blankworker1/PVA/README - 2026-10-20T141416.649.md

# PVA — Photovoltaic Art

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

Each panel is three things at once, in order of importance:

1. **A sundial.** A recycled panel on a wall that tells solar time with its gnomon. No visible digital layer: anyone can read it, every day, with no phone.
2. **A self-powered monitor.** Behind the panel, a small board records the panel's own sun every day. The record is collected on foot every fortnight and published on the PVA website as **Sole**: weekly editions of 63 dials, nine panels by seven days.
3. **An annual event.** Once a year, for about a week, **SUNDIAL** turns each panel's day of sun into an image drawn live on the visitor's phone through the panel's own Wi-Fi, sealed at sunset. Visitors can leave a line in each panel's book. The week becomes one four-colour screen print.

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

The three layers are specified against the carrier board in **[USES.md](USES.md)**. PVA runs all three.

> Status: drafts, not yet compiled or tested on hardware. Firmware draft 6 records everything the dial needs (sun sections, heat, presence); the panel page and `tools/pva_rules.py` both draw rules v1. Firmware 6.2 (security, visitors' book, pages built into the firmware, event archive by year) and the Sole tools are specified in USES.md, not yet written.

## How it fits together

| Layer | What it is | When | Where |
| --- | --- | --- | --- |
| **Sundial** | Gnomon, hour brackets and wall plate on the panel ([hardware/SUNDIAL.md](hardware/SUNDIAL.md)) | Always | On the wall |
| **Sole** | The panels' daily record of sun, collected every fortnight, published as weekly editions of 63 dials | All year | The PVA website |
| **SUNDIAL** | Each day's dial drawn live and sealed at sunset; the visitors' book; one print per event | One week a year | The panel's own Wi-Fi, then the website |

| Part | What it is | Where it runs |
| --- | --- | --- |
| The panel | PV panel + ESP32 + temperature probe + clock module, no battery, no internet | On a wall in Bosa |
| The dial | Each day's image, drawn on the visitor's phone from the panel's data | The panel's own Wi-Fi during SUNDIAL; the website for Sole |
| The visitors' book | One line per visitor per panel per day, read and chosen the next day | The panel's own Wi-Fi, during SUNDIAL |
| The map | Route, pins, which panels are likely awake, the visitor's position | The PVA website (this repo's `docs/`) |
| The website pages | SUNDIAL sheets (one per event) and Sole editions (one per week) | The PVA website (planned: `docs/sundial/`, `docs/sole/`) |
| The girasole | A sunflower and a chalkboard: the Heliotropist legend re-enacted, drawn by visitors | First stop of the route during SUNDIAL, moveable |
| The print | The whole event as one 9 × 9 four-colour screen print | Made after each event from the collected data |

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

## Repository

```
USES.md                       the three layers specified against carrier v1: sundial, Sole, SUNDIAL
docs/
  index.html                  the map — the only part published on the website
  sundial/, sole/, data/      planned: SUNDIAL sheets and Sole editions (USES.md 3.3)
firmware/panel_page_server/
  panel_page_server.ino       ESP32 firmware
  partitions.csv              4 MB flash layout for the ELEGOO ESP32 (~2 MB for pages and data)
  partitions_16mb.csv         16 MB layout for an ESP32-S3 (~9.9 MB)
  panel_config.example.h      template for per-panel settings
  data/                       copied into each panel's flash
    index.html                the panel page: today's dial, gallery of past days, live data
    admin.html                admin page: status, clock, exhibition dates, sun-sensor calibration, raw data download
    media/title.txt           this panel's name
    media/map.txt             the map's web address
texts/
  introduction.en.md          the exhibition introduction and the Heliotropism back story (draft)
  introduction.it.md          the same in Italian
  print-enquiry.md            for the print shop: the project, the print, the proposal, eleven questions
  print-enquiry.it.md         the same in Italian
  pva_sample_a4.pdf           A4 sample sheet of the dial (invented data), made by tools/sample_a4.py
  pva_sample_a4.it.pdf        the same in Italian
  pva_poster_mockup.pdf       A4 mock-up of the full print, 63 tiles (invented data), made by tools/poster_mockup.py
  pva_poster_mockup.it.pdf    the same in Italian
  pva_poster_pv_mockup.pdf    the wall version: 63 dials cut as solar cells on black (and .it.pdf)
  slow-art-sun-record.md      Slow Art: Sun Record, a year of Campbell–Stokes sunshine cards in 14 frames, plus sun-drawing workshops
hardware/
  CARRIER.md                  the carrier board: everything factory-fitted except the ESP32 and buck converter
  PVA_carrier_board_spec_v1.pdf  the same as a PDF, for sending to a board designer
  SUNDIAL.md                  the panel as a sundial: gnomon, drilling template, installation, wall test
tools/
  pva_rules.py                the dial rules as drawing code (canonical print, separations); rules-2 for Sole planned
  pva_import.py, sole_edition.py  planned: round downloads → SUNDIAL pages and Sole editions (USES.md 3.4)
  sample_a4.py                A4 sample sheet, invented data
  poster_mockup.py            A4 mock-up of the canonical print, invented data
  requirements.txt
```

## Publishing the map

In the repository's GitHub Pages settings, publish from the `docs` folder on the main branch, then point the PVA domain at it. Only `docs/` is published; the panel files stay in the repo but never appear online.

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

## Preparing a panel

1. **Settings.** Copy `panel_config.example.h` to `panel_config.h` and set the panel's Wi-Fi name (`panel-01` … `panel-09`) and a long, unique admin key. `panel_config.h` is ignored by git; keep the keys somewhere safe.
2. **Build stage.** Set the four switches at the top of the firmware (see the table below). Pins are preset for the ELEGOO 30-pin board; on an ESP32-S3, set them by hand.
3. **Media.** Edit `data/media/title.txt` (panel name) and `data/media/map.txt` (map address).
4. **Build.** Arduino IDE, ESP32 core 3.x; libraries OneWire, DallasTemperature, RTClib. ELEGOO: board *ESP32 Dev Module*, Flash 4 MB, Partition Scheme *Custom* (uses `partitions.csv` in the sketch folder). ESP32-S3: board *ESP32S3 Dev Module*, Flash 16 MB, PSRAM OPI, and rename `partitions_16mb.csv` to `partitions.csv`.
5. **Flash.** Erase all flash first (essential on any board that ever held keys), upload the firmware, then upload `data/` with the LittleFS uploader. **First installation only:** erasing or uploading `data/` wipes the panel's archive and logs. From firmware 6.2 the pages are built into the firmware, and a later update flashes the firmware alone, after a full download (USES.md 4.4).
6. **Set up on site.** Join the panel's Wi-Fi, open `http://192.168.4.1/admin.html`, enter the key, set the clock from your phone and set the exhibition's first and last day.
7. **Calibrate the sun sensor** (if fitted): on a clear day near solar noon, tap **Calibrate now**, **in the two weeks before each event**. On a vertical panel the noon current changes strongly with the season, so the reference must come from the event's own season. Until then the panel still logs the raw current, and the dial's sun sections are drawn as outline.

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

## Installation: the admin checklist (per panel)

**In the workshop**

1. **Settings.** `panel_config.h` from the example: Wi-Fi name (`panel-01` … `panel-09`) and a long, unique admin key, recorded somewhere safe.
2. **Media.** `title.txt` (panel name) and `map.txt` (map address).
3. **Stage switches** to match the hardware fitted. `BENCH` back to `0` before installing.
4. **Flash.** Arduino IDE, ESP32 Dev Module, Custom partitions: erase all flash, upload the firmware, upload `data/` with the LittleFS uploader.
5. **Power chain.** Buck converter set to exactly 5.0 V before anything is connected; then fuse, diode, supercapacitor, TVS.
6. **Sensors.** Probe on GPIO 4 · divider on GPIO 34 · DS3231 on GPIO 21/22 · sun sensor gate on GPIO 25, amplifier on GPIO 35.
7. **Bench test.** On USB: set the clock, set the exhibition dates to today, check status (clock module fitted, probe found, voltage plausible), watch a dial form.
8. **Frame.** Drill from the template; fit the gnomon at 50°, the 13 numbered hour brackets and the stand-off brackets ([hardware/SUNDIAL.md](hardware/SUNDIAL.md)).

**On site**

9. **Permission** from the wall owner and the Comune (and heritage authorities in the centro storico) **for a permanent installation**, plus public liability insurance (USES.md section 5).
10. **Wall test.** Compass for a first reading, then the noon-shadow test: which edge packs out, and by how much.
11. **Mount.** Cut the stand-offs, hang, spirit level against the glass; box on the deep side, probe on the panel back.
12. **Wall plate** beside the panel: its number and the QR code.
13. **Solar-noon check.** The shadow falls on the 12 bracket; adjust the stand-offs if not.
14. **Admin page.** Join the panel's Wi-Fi, open `http://192.168.4.1/admin.html`, enter the key, set the clock and the exhibition dates.
15. **Calibrate the sun sensor** on a clear day near solar noon, in the two weeks before the event starts. Uncalibrated, every section draws as an outline.
16. **Map pin.** Map with `?edit`, drag the pin, copy the positions into `docs/index.html`, push.

**The girasole (once, for the whole trail)**

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

**During the run**

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

**After the run**

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

**All year (Sole)**

20. **Fortnightly round, every second Monday:** status, clock check, full download, clean the glass, check gnomon, plate and box; one line per panel in the round log. Then import, build the two new weekly editions, push. Details: USES.md 3.2.

**Every year (USES.md 4.4)**

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

## The visitor's experience

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

## To do

- [ ] **Import script:** turn an admin download into tile data for `pva_rules.py`, the canonical sheet and the website page.
- [ ] **Separations script:** one file per ink for the screen print.
- [ ] **Website page** for the canonical sheet, filled after each day's round.
- [ ] **Calibration** of every panel before the run; prove the step on the pilot.
- [ ] **"How to read the dial" key** in the panel page's info overlay, as well as on the flyer and website.
- [ ] **Italian and English** on the panel page, info overlay and map.
- [ ] **"Stay connected"** wording on the flyer or wall plate: some phones warn about or drop a network with no internet.
- [x] **After the last day:** the panel page shows the archive of past events (USES.md 4.1).
- [ ] **Firmware 6.2** (USES.md 4.1): challenge-and-response admin login with round and setup keys, lockout and action log; the visitors' book; pages built into the firmware; no visitor clock-setting when the clock module is fitted; rules version check; event archive by year.
- [ ] **Permissions** for a permanent installation: wall owners, Comune and heritage, insurance (USES.md section 5).
- [ ] **Sole tools and pages:** rules-2 in `pva_rules.py`, `pva_import.py`, `sole_edition.py`, `docs/sole/` and `docs/sundial/` (USES.md 3.3–3.4).
- [ ] **First compile and bench test** of firmware draft 6.
- [ ] **The girasole:** sunflower variety and sowing in May; a moveable chalkboard and its stand; where it stands on the route.
- [ ] **Hour lines on the glass** (test on the pilot panel): thin or dotted lines radiating from the gnomon root at the hour-line angles in `hardware/SUNDIAL.md`, in removable UV-stable pinstripe tape first. Measure short-circuit current near solar noon with and without the lines. If the loss is negligible and the dial reads well, keep the lines and shorten the gnomon (safer, less reach from the wall), since the shadow is then read along the line, not at the brackets.

**Optional**

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

## Hardware per panel

Each panel is also a vertical sundial, mounted vertical and facing due south: see [hardware/SUNDIAL.md](hardware/SUNDIAL.md) for the gnomon, the drilling template, the installation and the noon-shadow wall test.

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

**Stage 2 adds** (or the carrier board in `hardware/CARRIER.md`, which fits all of this): fuse and reverse-polarity diode on the panel side · SMAJ5.0A TVS diode across 5 V · panel-voltage divider 100 kΩ / 5.6 kΩ + 100 nF into GPIO 34 (must be GPIO 32–39: the other analog pins stop working with Wi-Fi on) · DS3231 clock module on GPIO 21/22.

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

## The dial (rules v1, draft)

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

*Horas non numero nisi serenas* — I count only the sunny hours.

## What a panel records

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

## Data and privacy

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
