blankworker1/PVA/texts/pva_poster_pv_mockup.it.pdf

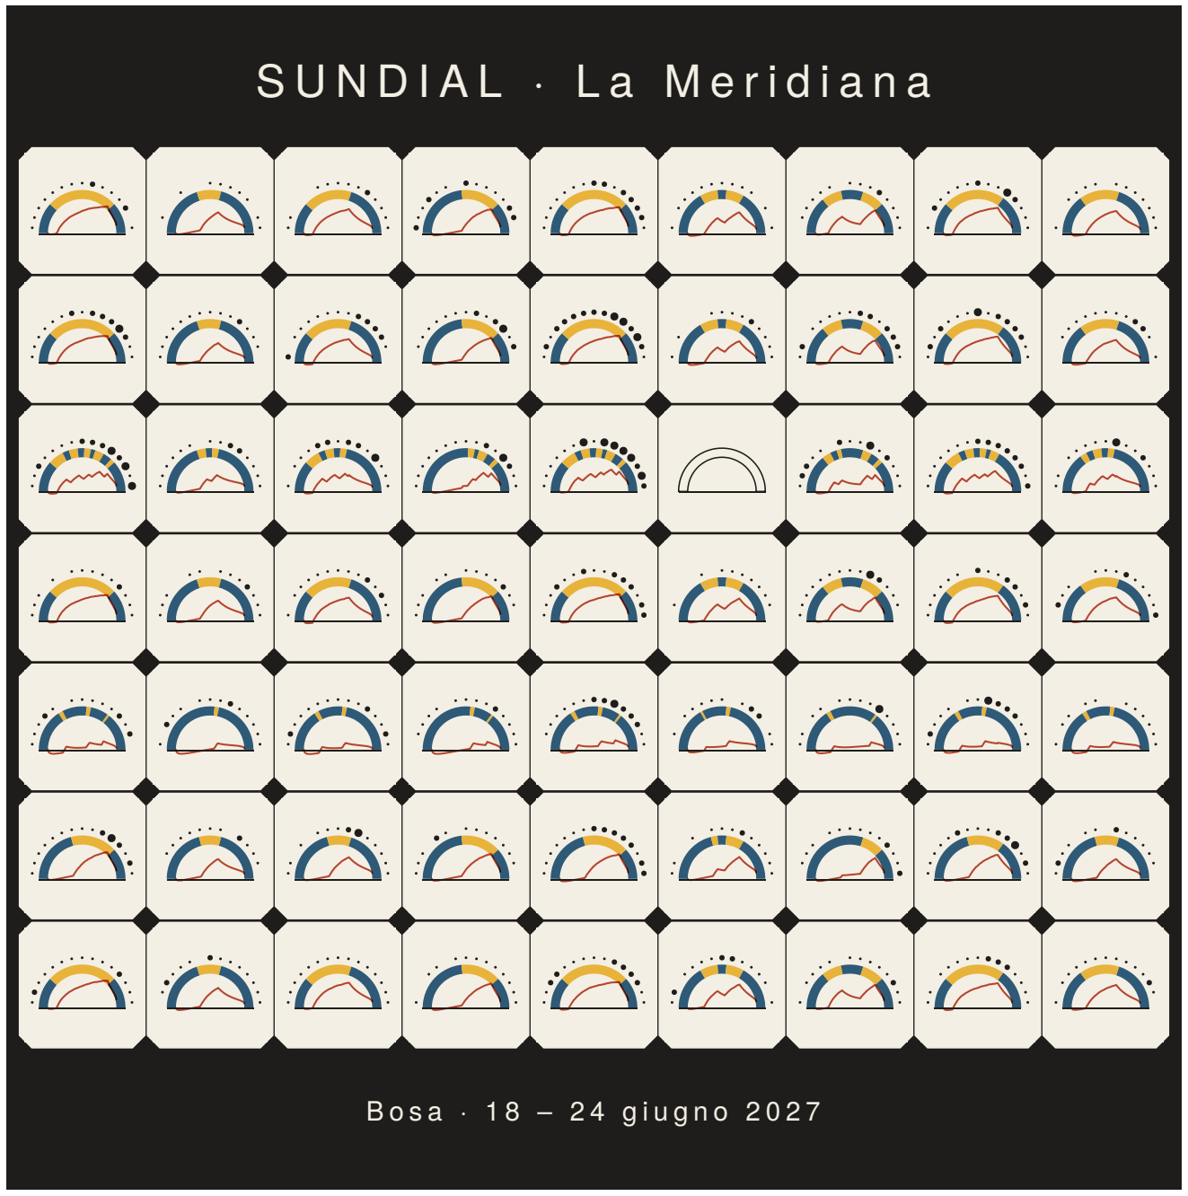
[picture p1: figure]

Bozza della versione a parete · 9 pannelli (colonne) × 7 giorni (righe) · dati inventati · regole v1 (bozza)
Lo stesso cielo per tutti e nove: nuvole il 20, coperto il 22, mattina nuvolosa il 23. Il pannello 6 non si è acceso il 20.
63 fogli A4 tagliati a celle di 210 mm, angoli smussati di 30 mm, su nero: il rovescio di un pannello vero. Fughe 2 mm (luoghi), 4 mm (giorni). Misura 1,95 × 1,96 m.
