blankworker1/PVA/texts/introduction.it.md

<!-- Bozza, ottobre 2026. Copia di lavoro: il doc "SUNDIAL · La Meridiana – Exhibition Introduction", scheda Italiano. Non ancora pubblicato. -->

# SUNDIAL · La Meridiana

**Nove pannelli. Un solo sole. Sette giorni a Bosa.**

Per sette giorni attorno al solstizio d'estate, nove vecchi pannelli solari sono appesi ai muri di Bosa. Hanno finito la loro vita di lavoro sui tetti. Ora gli resta un solo compito: guardare il sole, e fare un'immagine di ciò che hanno visto.

Ogni pannello alimenta soltanto sé stesso. Niente batteria, niente cavi, niente internet. Quando arriva la luce, il pannello si sveglia. Per tutto il giorno registra il sole sul proprio vetro, quanto si scalda e chi si ferma a fargli visita. Da questo, secondo regole fisse, disegna un'unica immagine: il quadrante della sua giornata. L'immagine si forma dal vivo, minuto dopo minuto, e viene sigillata al tramonto di Bosa. Da quel momento nulla può più cambiarla.

La si può vedere solo lì, davanti al pannello, sul proprio telefono, attraverso il Wi-Fi del pannello stesso. Ogni pannello è anche una vera meridiana: la sua ombra segna l'ora solare, mentre i suoi dati disegnano la giornata.

Tutti e nove i pannelli vedono lo stesso sole. Nessuno vede la stessa giornata. Una via che guarda il mare, un muro all'ombra del castello, un vicolo che perde il sole alle tre del pomeriggio: ogni luogo si scrive nel proprio quadrante. **Stesso sole, dati diversi.**

A settimana finita, i 63 quadranti, nove pannelli per sette giorni, diventano un'unica serigrafia, stampata a Bosa in quattro inchiostri: tutta la mostra in un solo foglio.

*Horas non numero nisi serenas.* Conto solo le ore serene.

## Visitare

- **Quando:** sette giorni a giugno 2027, attorno al solstizio (date da confermare). I pannelli si svegliano con la luce e si spengono dopo il tramonto: non ci sono orari di apertura, se non quelli del sole.
- **Dove:** nove muri di Bosa. Inquadra il codice QR sul volantino o sulla targa di un pannello: trovi la mappa, il percorso e quali pannelli sono svegli in quel momento.
- **Si parte dal girasole:** la prima tappa sulla mappa. Un giovane girasole si volge al sole accanto a una lavagna: lascia il tuo segno, ocra per il sole o blu per l'ombra, e scrivi l'ora. Al tramonto la lavagna si cancella, pronta per il giorno dopo.
- **Come:** davanti a un pannello, collegati al suo Wi-Fi (da `panel-01` a `panel-09`). La pagina si apre da sola. Resta collegato anche se il telefono dice che non c'è internet: non c'è, ed è voluto.
- **Costo:** gratuito. La tua visita viene contata, mai identificata: diventa un piccolo punto nero su quell'ora del quadrante.

## Eliotropismo: una breve storia, in gran parte inventata

L'**Eliotropismo** è l'arte di volgersi verso il sole. Il nome viene dalla botanica, dove indica una pianta che segue il sole nel cielo: da *Helios*, il sole, e *tropos*, il volgersi. I suoi seguaci sono gli Eliotropisti. Il suo motto è l'antica iscrizione delle meridiane, *Horas non numero nisi serenas*, e le sue opere le fa il sole e non le firma nessuno.

**La leggenda.** Gli Eliotropisti dicono che il loro primo membro fu un girasole. Nessuno lo aveva piantato. Un uccello lasciò cadere il seme in una crepa, ai piedi di un vecchio muro rivolto al mare, in una città sul fiume, sotto una meridiana così consumata che se ne leggeva solo il motto: *Horas non numero nisi serenas*.

Per tutta l'estate il fiore fece ciò che fanno i girasoli. Seguì il sole da est a ovest, e ogni notte, al buio, si rigirò verso est ad aspettare. Quando passava una nuvola, aspettava. Quando il sole scendeva dietro il castello, aspettava. Dopo il tramonto non contava niente. La meridiana sopra di lui non sapeva più segnare le ore; il fiore, sotto, segnava soltanto quali erano serene.

Qualcuno che passava ogni giorno davanti al muro cominciò a tracciare segni sul muro dietro il girasole: un segno ogni quarto d'ora, un colore per il sole e un altro per l'ombra, ogni giornata chiusa al tramonto e mai più toccata. Alla fine dell'estate il muro era coperto di giornate senza firma, nessuna uguale all'altra, tutte fatte dallo stesso sole. Il girasole andò in seme. I segni rimasero sul muro. Quella, dicono gli Eliotropisti, fu la prima mostra.

**I secoli silenziosi.** Per molto tempo l'Eliotropismo ha avuto pochissimi membri dichiarati, perché un Eliotropista non può dire di esserlo. La sua storia è scritta nei vuoti: meridiane senza firma, ombre lasciate a disegnare da sole, barattoli forati lasciati sulle recinzioni per mezzo anno. Gli Eliotropisti riconoscono le opere gli uni degli altri, mai le persone.

**I pannelli.** L'Eliotropismo aspettava un materiale capace di vedere il sole e anche di dimenticarlo. Lo ha trovato nel pannello solare a fine vita: troppo stanco per alimentare una casa, ancora abbastanza sveglio per accorgersi della luce. SUNDIAL · La Meridiana è, dicono gli Eliotropisti, la prima mostra del movimento dai tempi del girasole, e anche l'ultima, fino alla prossima. I pannelli restano fermi; sono i visitatori a volgersi, camminando da un muro all'altro dietro la luce.

**Eliotropisti senza saperlo.** Il movimento è molto più grande di quanto i suoi membri ammettano. Ogni estate migliaia di persone si volgono a sud e seguono il sole fino a paesi come Bosa: organizzano le giornate in base a lui, spostano l'asciugamano con l'ombra, giudicano una vacanza dalle sue ore di sole. Per gli Eliotropisti, ognuno di loro è un membro. Come i pannelli, tornano ogni anno sotto lo stesso sole, e come i pannelli, nessuno di loro ha la stessa giornata.

**Le regole dell'Eliotropismo**

1. L'opera la fa il sole. L'artista scrive solo le regole, e le regole sono fissate prima della prima luce.
2. Un pannello, un luogo, un giorno. Ogni opera appartiene al luogo in cui è nata.
3. Un'opera è finita al tramonto. Ciò che viene dopo il buio non si conta.
4. L'ombra non è un fallimento. Il blu è una registrazione vera, non una mancanza.
5. Un giorno in cui il pannello non si è svegliato è comunque un'opera: il contorno di ciò che avrebbe potuto essere.
6. L'opera si vede dove nasce, o non si vede affatto.
7. I visitatori si contano, non si nominano.
8. L'opera non la firma nessuno. Al posto della firma, le regole portano un numero di versione.
9. Conta solo le ore serene.
