blankworker1/PVA/texts/pva_sample_a4.it.pdf

# SUNDIAL · La Me ridiana

### PVA Bosa · foglio di prova · regole v1 (bozza) · due giorni, due luoghi

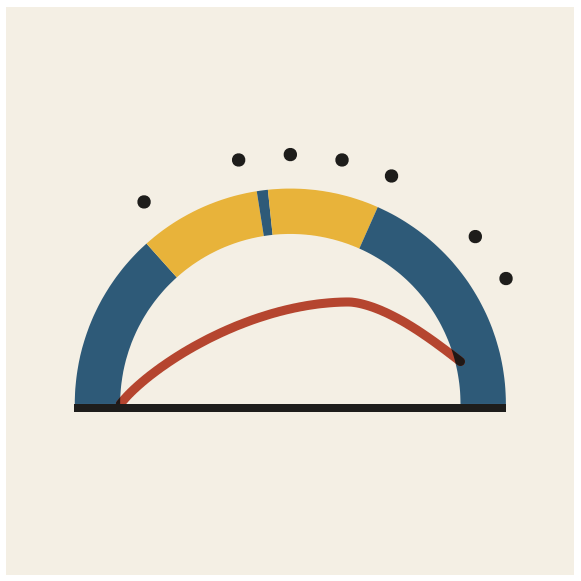
[picture p2: figure]

## Pannello 3 · vicolo stretto

21 giugno 2026 · alba 05:57 · mezzodì solare 13:29 · tramonto 21:00

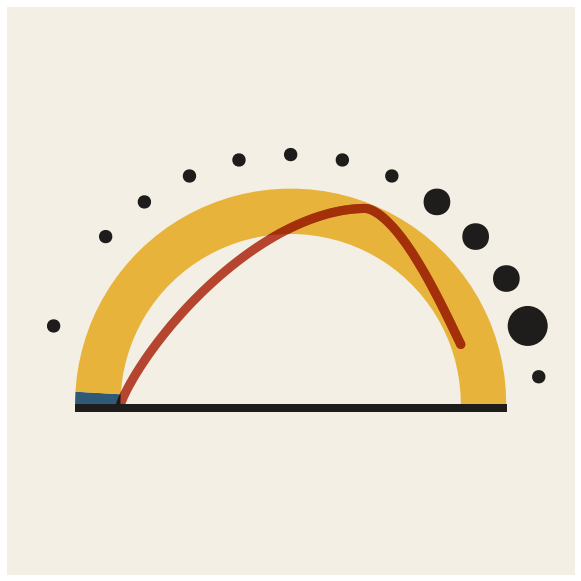
[picture p3: figure]

## Pannello 9 · di fronte al mare

21 giugno 2026 · alba 05:57 · mezzodì solare 13:29 · tramonto 21:00

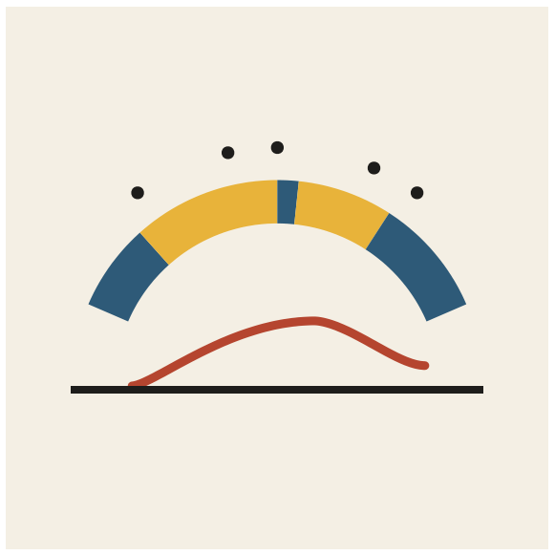
[picture p4: figure]

## Pannello 3 · vicolo stretto

16 ottobre 2026 · alba 07:38 · mezzodì solare 13:12 · tramonto 18:46

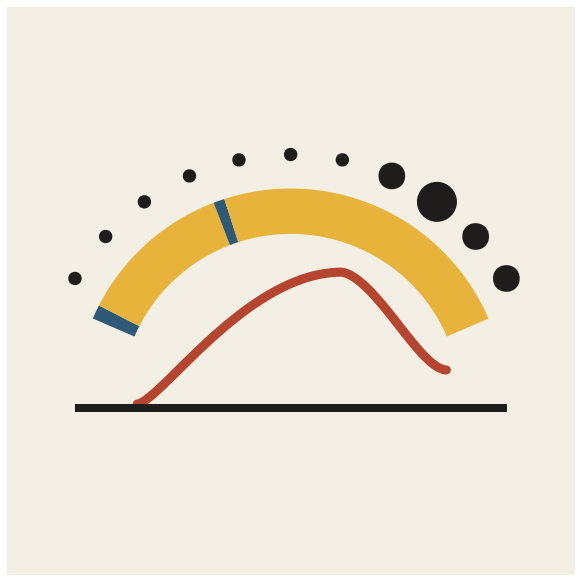
[picture p5: figure]

## Pannello 9 · di fronte al mare

16 ottobre 2026 · alba 07:38 · mezzodì solare 13:12 · tramonto 18:46

Un giorno in cui il pannello non si è acceso: il contorno dell'anello e l'asse, solo in nero. Sono le linee più sottili del foglio.

al sole | non al sole | calore: aumento dall'alba, +40 °C all'anello | visitatori per ora solare: 1–5 · 6–10 · 11+

Dati inventati, a scopo illustrativo. Ampiezza dell'arco = durata del giorno rispetto al solstizio di Bosa (180°). Mezzogiorno solare in alto.
