blankworker1/PVA/texts/pva_sample_a4.pdf

# SUNDIAL · La Me ridiana

### PVA Bosa · sample sheet · rules v1 (draft) · two days, two locations


## Panel 3 · narrow street

21 June 2026 · sunrise 05:57 · solar noon 13:29 · sunset 21:00


## Panel 9 · facing the sea

21 June 2026 · sunrise 05:57 · solar noon 13:29 · sunset 21:00


## Panel 3 · narrow street

16 October 2026 · sunrise 07:38 · solar noon 13:12 · sunset 18:46


## Panel 9 · facing the sea

16 October 2026 · sunrise 07:38 · solar noon 13:12 · sunset 18:46

A day the panel did not wake: the outline of the ring and the axis, in black only. These are the thinnest lines on the sheet.

in sun | not in sun | heat: rise since sunrise, +40 °C at the ring | visitors per solar hour: 1–5 · 6–10 · 11+

Invented data for illustration. Arc angle = day length against Bosa's solstice day (180°). Solar noon at the top.
