blankworker1/PVA/texts/print-enquiry.it.md

<!-- Bozza, ottobre 2026. Copia di lavoro: il doc "SUNDIAL · La Meridiana – Per la stamperia" (scheda Italiano). Per il titolare della stamperia, con pva_sample_a4.it.pdf. -->

# SUNDIAL · La Meridiana – Per la stamperia

## Il progetto

**SUNDIAL · La Meridiana** è la prima mostra di PVA (Photovoltaic Art), a Bosa, per sette giorni attorno al solstizio d'estate 2027. Nove vecchi pannelli solari, appesi ai muri del paese, alimentano soltanto sé stessi: niente batteria, niente cavi, niente internet. Ogni pannello è anche una vera meridiana.

Ogni giorno ogni pannello registra il sole sul proprio vetro, quanto si scalda e chi si ferma a fargli visita, e secondo regole fisse ne disegna un'immagine: il quadrante della sua giornata, sigillato al tramonto. Durante la mostra lo si vede solo sul telefono, davanti al pannello. **Stesso sole, dati diversi.**

A mostra finita, i 63 quadranti (nove pannelli per sette giorni) diventano un'unica serigrafia in quattro inchiostri, stampata a Bosa: tutta la mostra in un solo foglio. È questa la stampa che vorremmo realizzare e vendere con voi.

## La stampa

| Voce | Specifica |
| --- | --- |
| Impaginazione | Quadrata, griglia 9 × 9: 63 riquadri immagine (9 pannelli × 7 giorni); "SUNDIAL · La Meridiana" centrato nella riga in alto, le date centrate nella riga in basso |
| Colori | 4 inchiostri a tinta piatta, stampati dal più chiaro al più scuro: ocra, rosso, blu, nero |
| Sovrastampa | Inchiostri trasparenti: il rosso sopra l'ocra o il blu crea un terzo colore |
| Grafica | Forme vettoriali piatte, senza sfumature né retini |
| Linee più sottili | Da fissare con voi in millimetri, una volta nota l'area di stampa (vedi domanda 1). Alcuni riquadri, i giorni in cui un pannello non si è acceso, sono solo un contorno nero sottile |
| File | Forniamo le quattro selezioni a misura di stampa, con crocini di registro, pronte per la pellicola |
| Formato | Il più grande che il vostro telaio permette, immagine quadrata, carta quadrata |

## La proposta

La stamperia realizza i telai, stampa e vende le stampe, che si possono ordinare in qualsiasi momento dopo la mostra. PVA resta proprietaria dei telai (o delle pellicole, se è più pratico). Ogni stampa deve essere uguale alla prima, in qualunque momento venga fatta.

## Le domande

1. **Area di stampa:** qual è l'immagine più grande che potete stampare con il vostro telaio più grande? Da questa dipendono la misura di ogni riquadro e lo spessore minimo delle linee.
2. **Linee sottili:** qual è la linea più sottile che tenete con sicurezza su carta, in quattro passaggi?
3. **Carta:** quale carta consigliate per quattro colori, e potete tagliarla quadrata (per esempio 70 × 70 cm da un 70 × 100)?
4. **Inchiostri:** stampate su carta con inchiostri all'acqua, e potete aggiungere la base trasparente per la sovrastampa? Potete annotare le miscele, così che le stampe successive siano uguali?
5. **Registro:** potete mettere a registro quattro colori con precisione, con giostra, tavolo o spine?
6. **Prova:** potreste tirare una piccola prova di rosso sopra ocra, e di una linea sottile nera, sulla carta scelta?
7. **Telai o pellicole:** è meglio che PVA tenga quattro telai, oppure le pellicole, rifacendo i telai quando serve? Dove verrebbero conservati?
8. **Tiratura:** aperta (stampata su richiesta) o limitata e numerata? Cosa consigliate?
9. **Costi e vendite:** costi di avviamento (pellicole, telai), prezzo per stampa e come dividere i ricavi.
10. **Tempi:** quanto tempo dalla consegna dei file alle prime stampe?
11. **Vendita:** in negozio, online, o entrambi?

## Il foglio di prova

Quattro quadranti con dati inventati: due luoghi, il giorno del solstizio e un giorno d'ottobre. In basso, un giorno in cui il pannello non si è acceso, solo in nero: sono le linee più sottili della stampa. Vedi `pva_sample_a4.it.pdf`.

**Come si legge un quadrante.** L'anello va dall'alba (a sinistra) al tramonto (a destra), con il mezzogiorno solare in alto; è diviso in quarti d'ora, ocra quando il pannello è al sole, blu quando non lo è. La linea rossa è il calore del pannello, che sale dall'alba. I punti neri sono i visitatori, uno per ogni ora solare. La barra nera in basso è l'orizzonte e il sigillo del tramonto.
