blankworker1/PVA/texts/pva_poster_mockup.pdf

# S U N D I A L · L a M e r i d i a n a

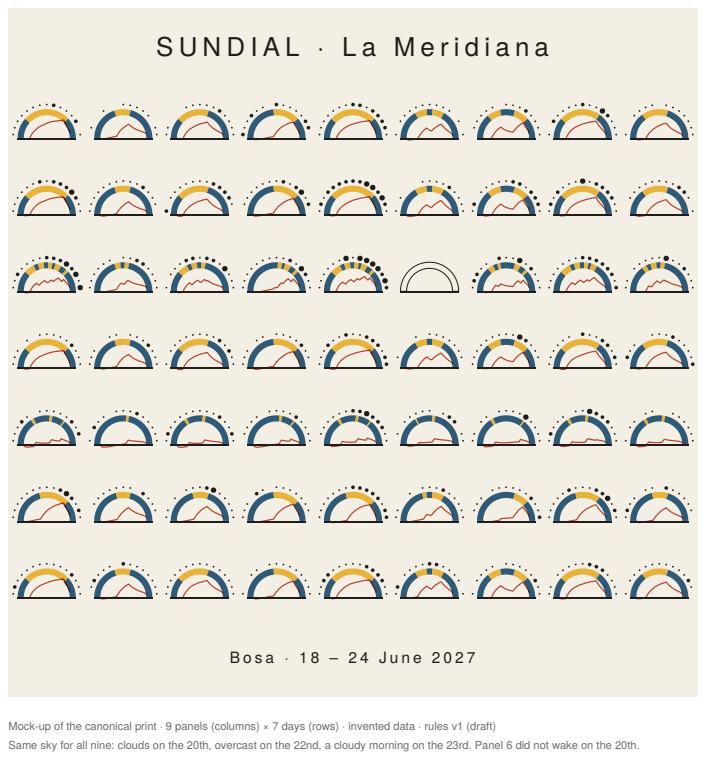
[picture p6: page 1]

Mock-up of the canonical print · 9 panels (columns) × 7 days (rows) · invented data · rules v1 (draft)
Same sky for all nine: clouds on the 20th, overcast on the 22nd, a cloudy morning on the 23rd. Panel 6 did not wake on the 20th.
