blankworker1/PVA/texts/pva_poster_pv_mockup.pdf

# S U N D I A L · L a M e r i d i a n a

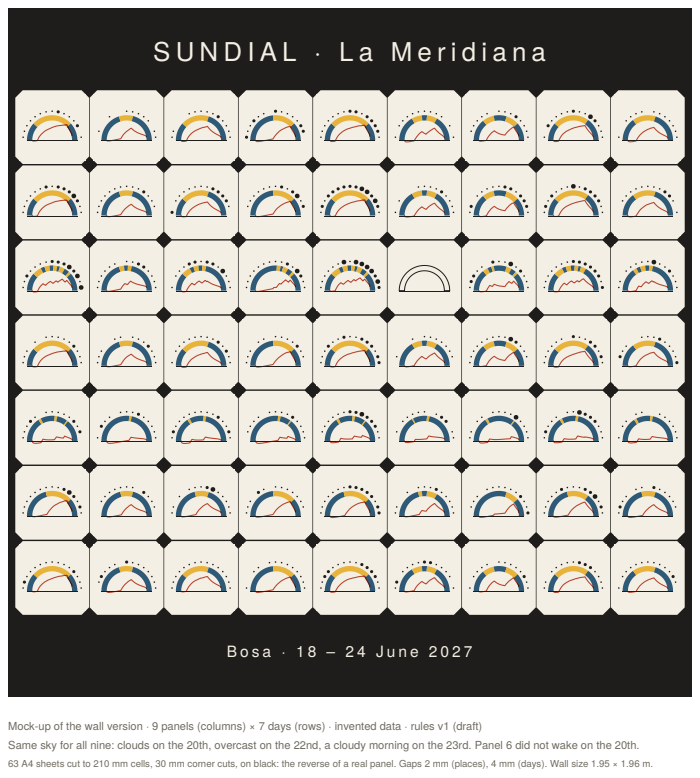
[picture p7: page 1]

Mock-up of the wall version · 9 panels (columns) × 7 days (rows) · invented data · rules v1 (draft)
Same sky for all nine: clouds on the 20th, overcast on the 22nd, a cloudy morning on the 23rd. Panel 6 did not wake on the 20th.
63 A4 sheets cut to 210 mm cells, 30 mm corner cuts, on black: the reverse of a real panel. Gaps 2 mm (places), 4 mm (days). Wall size 1.95 × 1.96 m.
