blankworker1/PVA/hardware/carrier/carrier_schematic.pdf

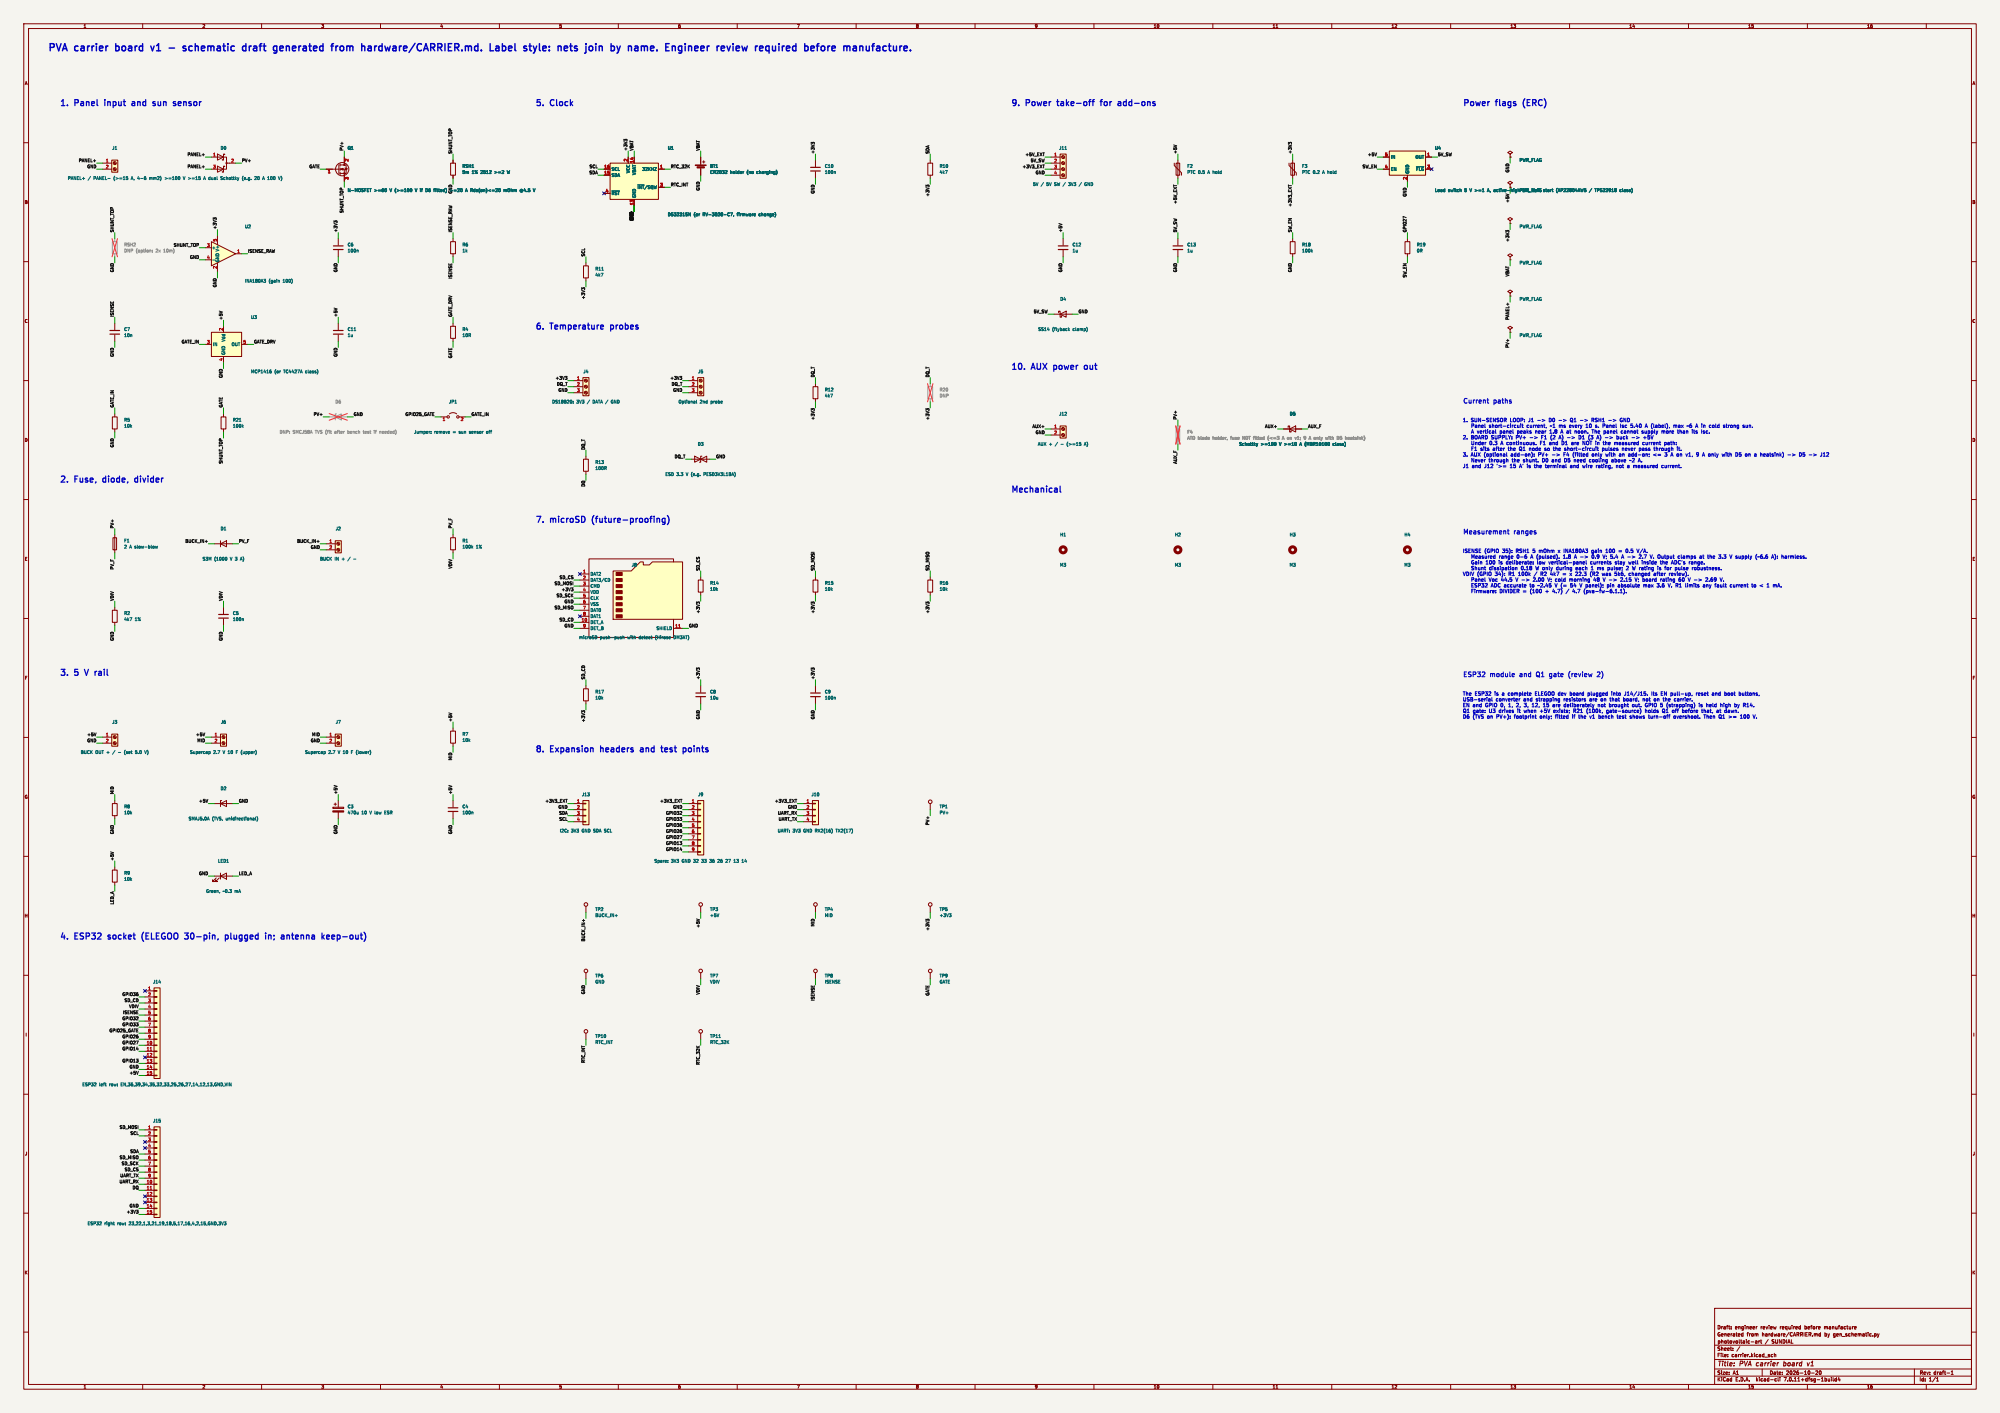
[picture p8: page 1]

1. Panel input and sun sensor

2 3 Q1 N-MOSFET >=60 V (>=100 V if D6 fitted) >=20 A Rds(on)<=20 mOhm @4.5 V

2 ~{INT}/SQW3 ~{RST} 4 Q1 N-MOSFET >=60 V (>=100 V if D6 fitted) >=20 A Rds(on)<=20 mOhm @4.5 V

2 ~{INT}/SQW3 ~{RST} 4 U1 DS3231SN (or RV-3028-C7, firmware change) R6

Load switch 5 V >=1 A, active-high PWR_FLAG EN, soft start (AP22804AW5 / TPS22918 class) D6 DNP: SMCJ58A TVS (fit after bench test if needed)

Jumper: remove = sun sensor off

ESP32 module and Q1 gate (review 2)

8. Expansion headers and test points

J10 UART: 3V3 GND RX2(16) TX2(17) LED1 Green, ~0.3 mA

J14 ESP32 left row: EN,36,39,34,35,32,33,25,26,27,14,12,13,GND,VIN

Id: 1/1 Title: PVA carrier board v1
