blankworker1/PVA/hardware/carrier/carrier.kicad_sch

## KiCad design hardware/carrier/carrier.kicad_sch (2026-10-20)

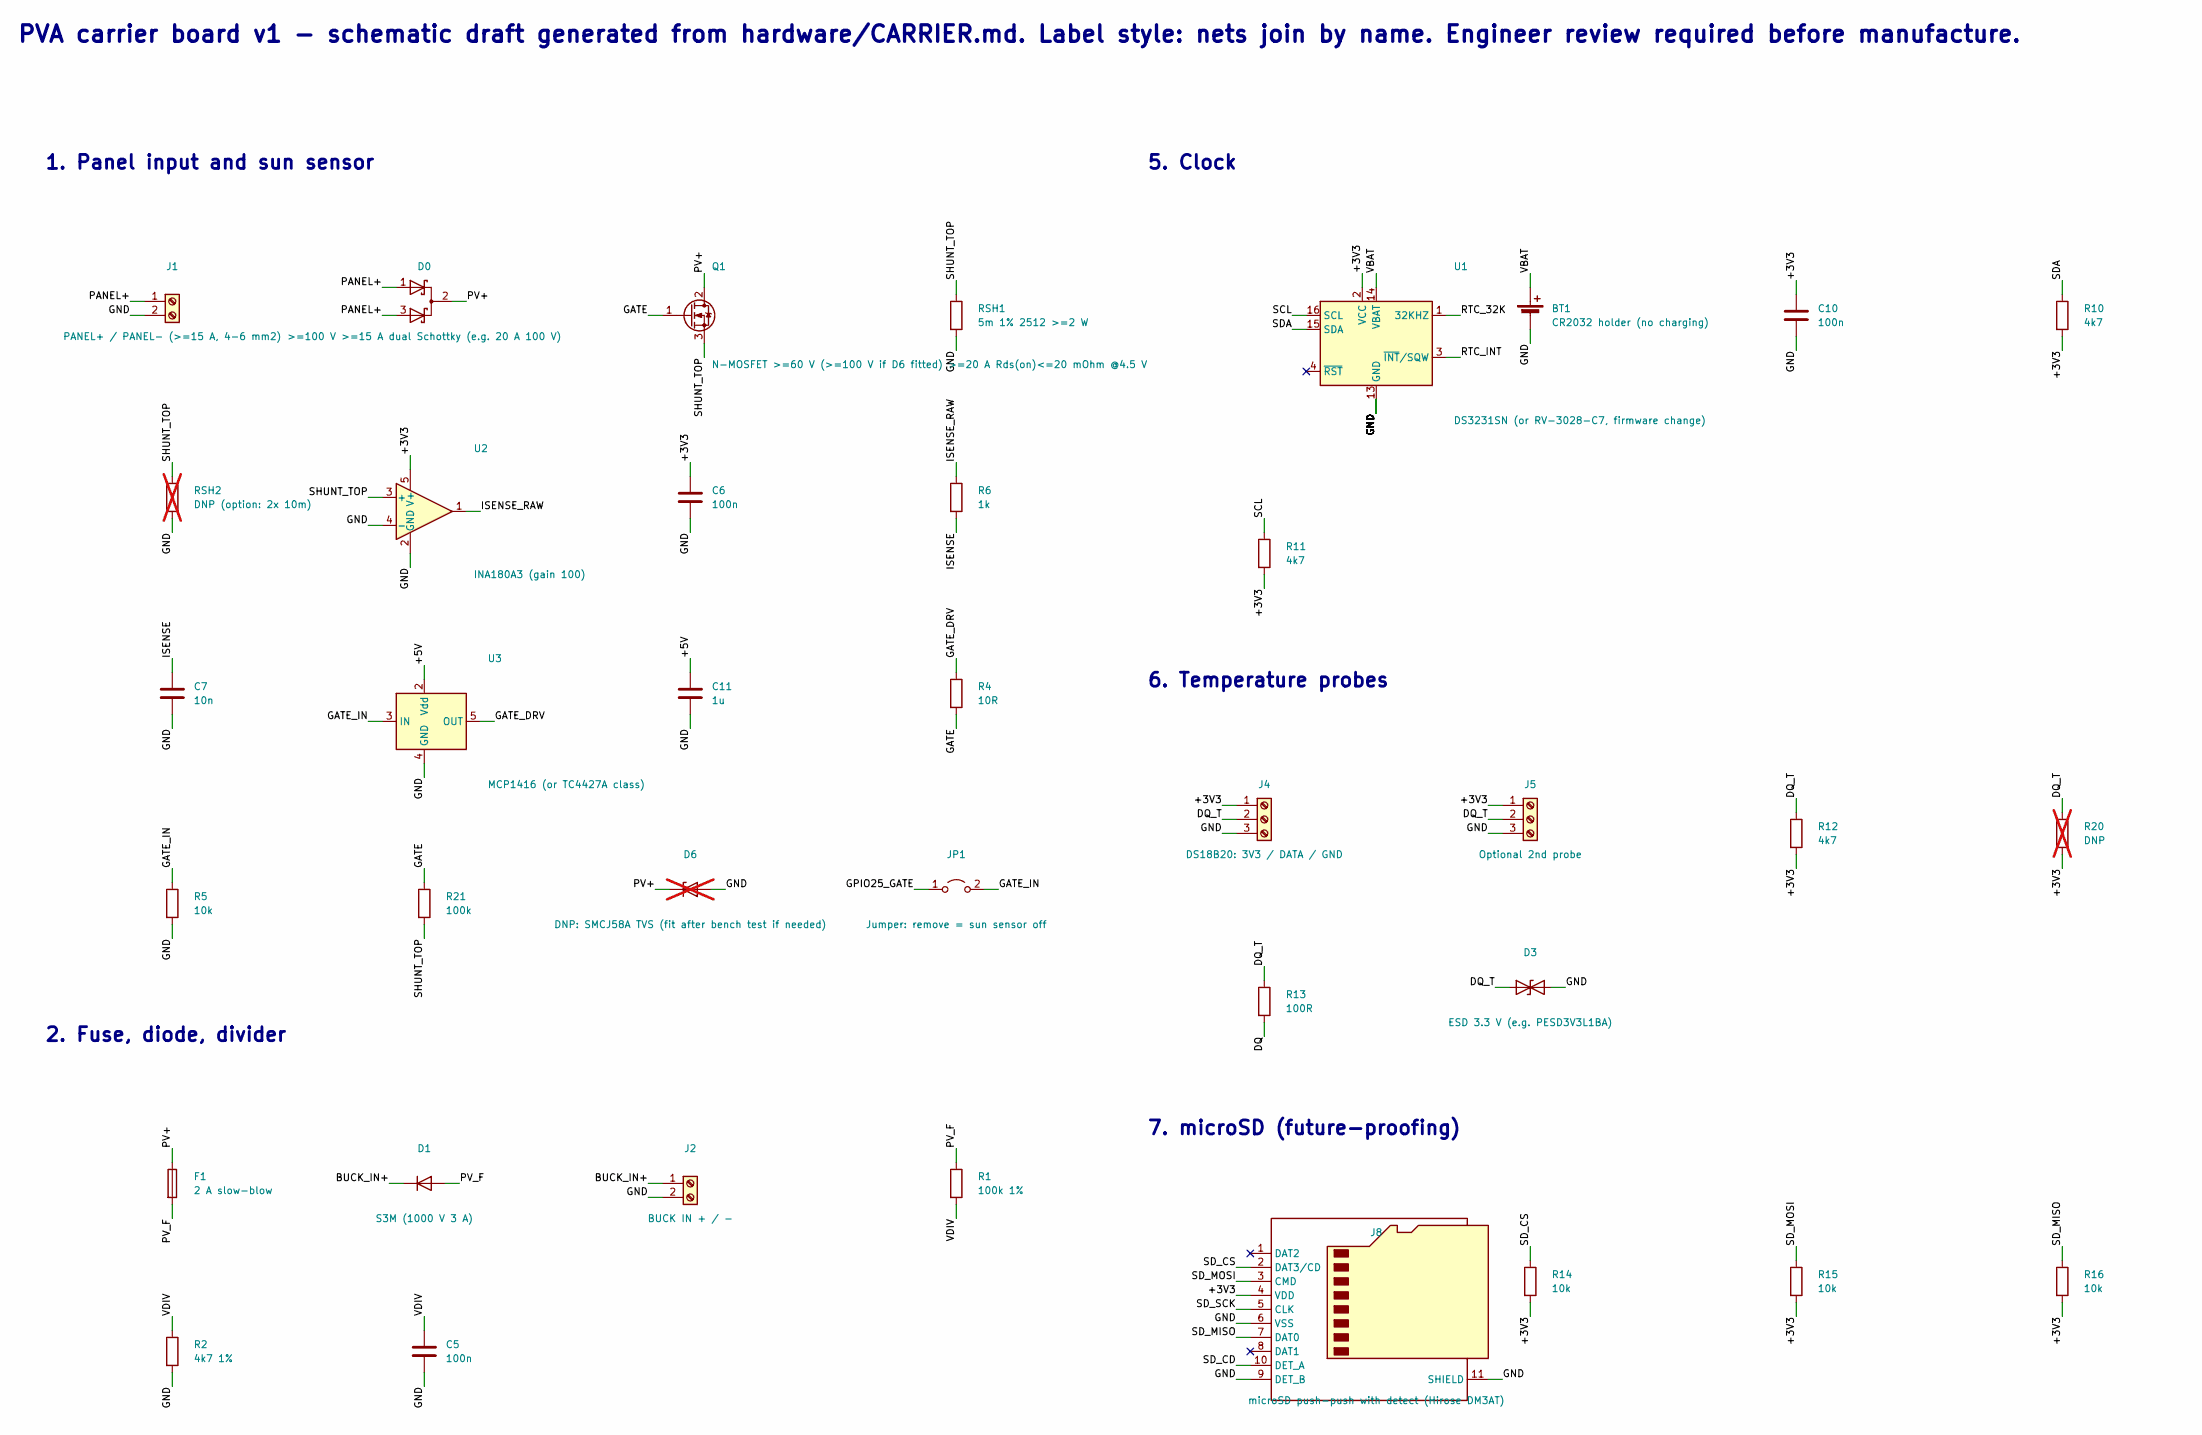
[picture p9: schematic carrier.kicad_sch, part in row 1, column 1]

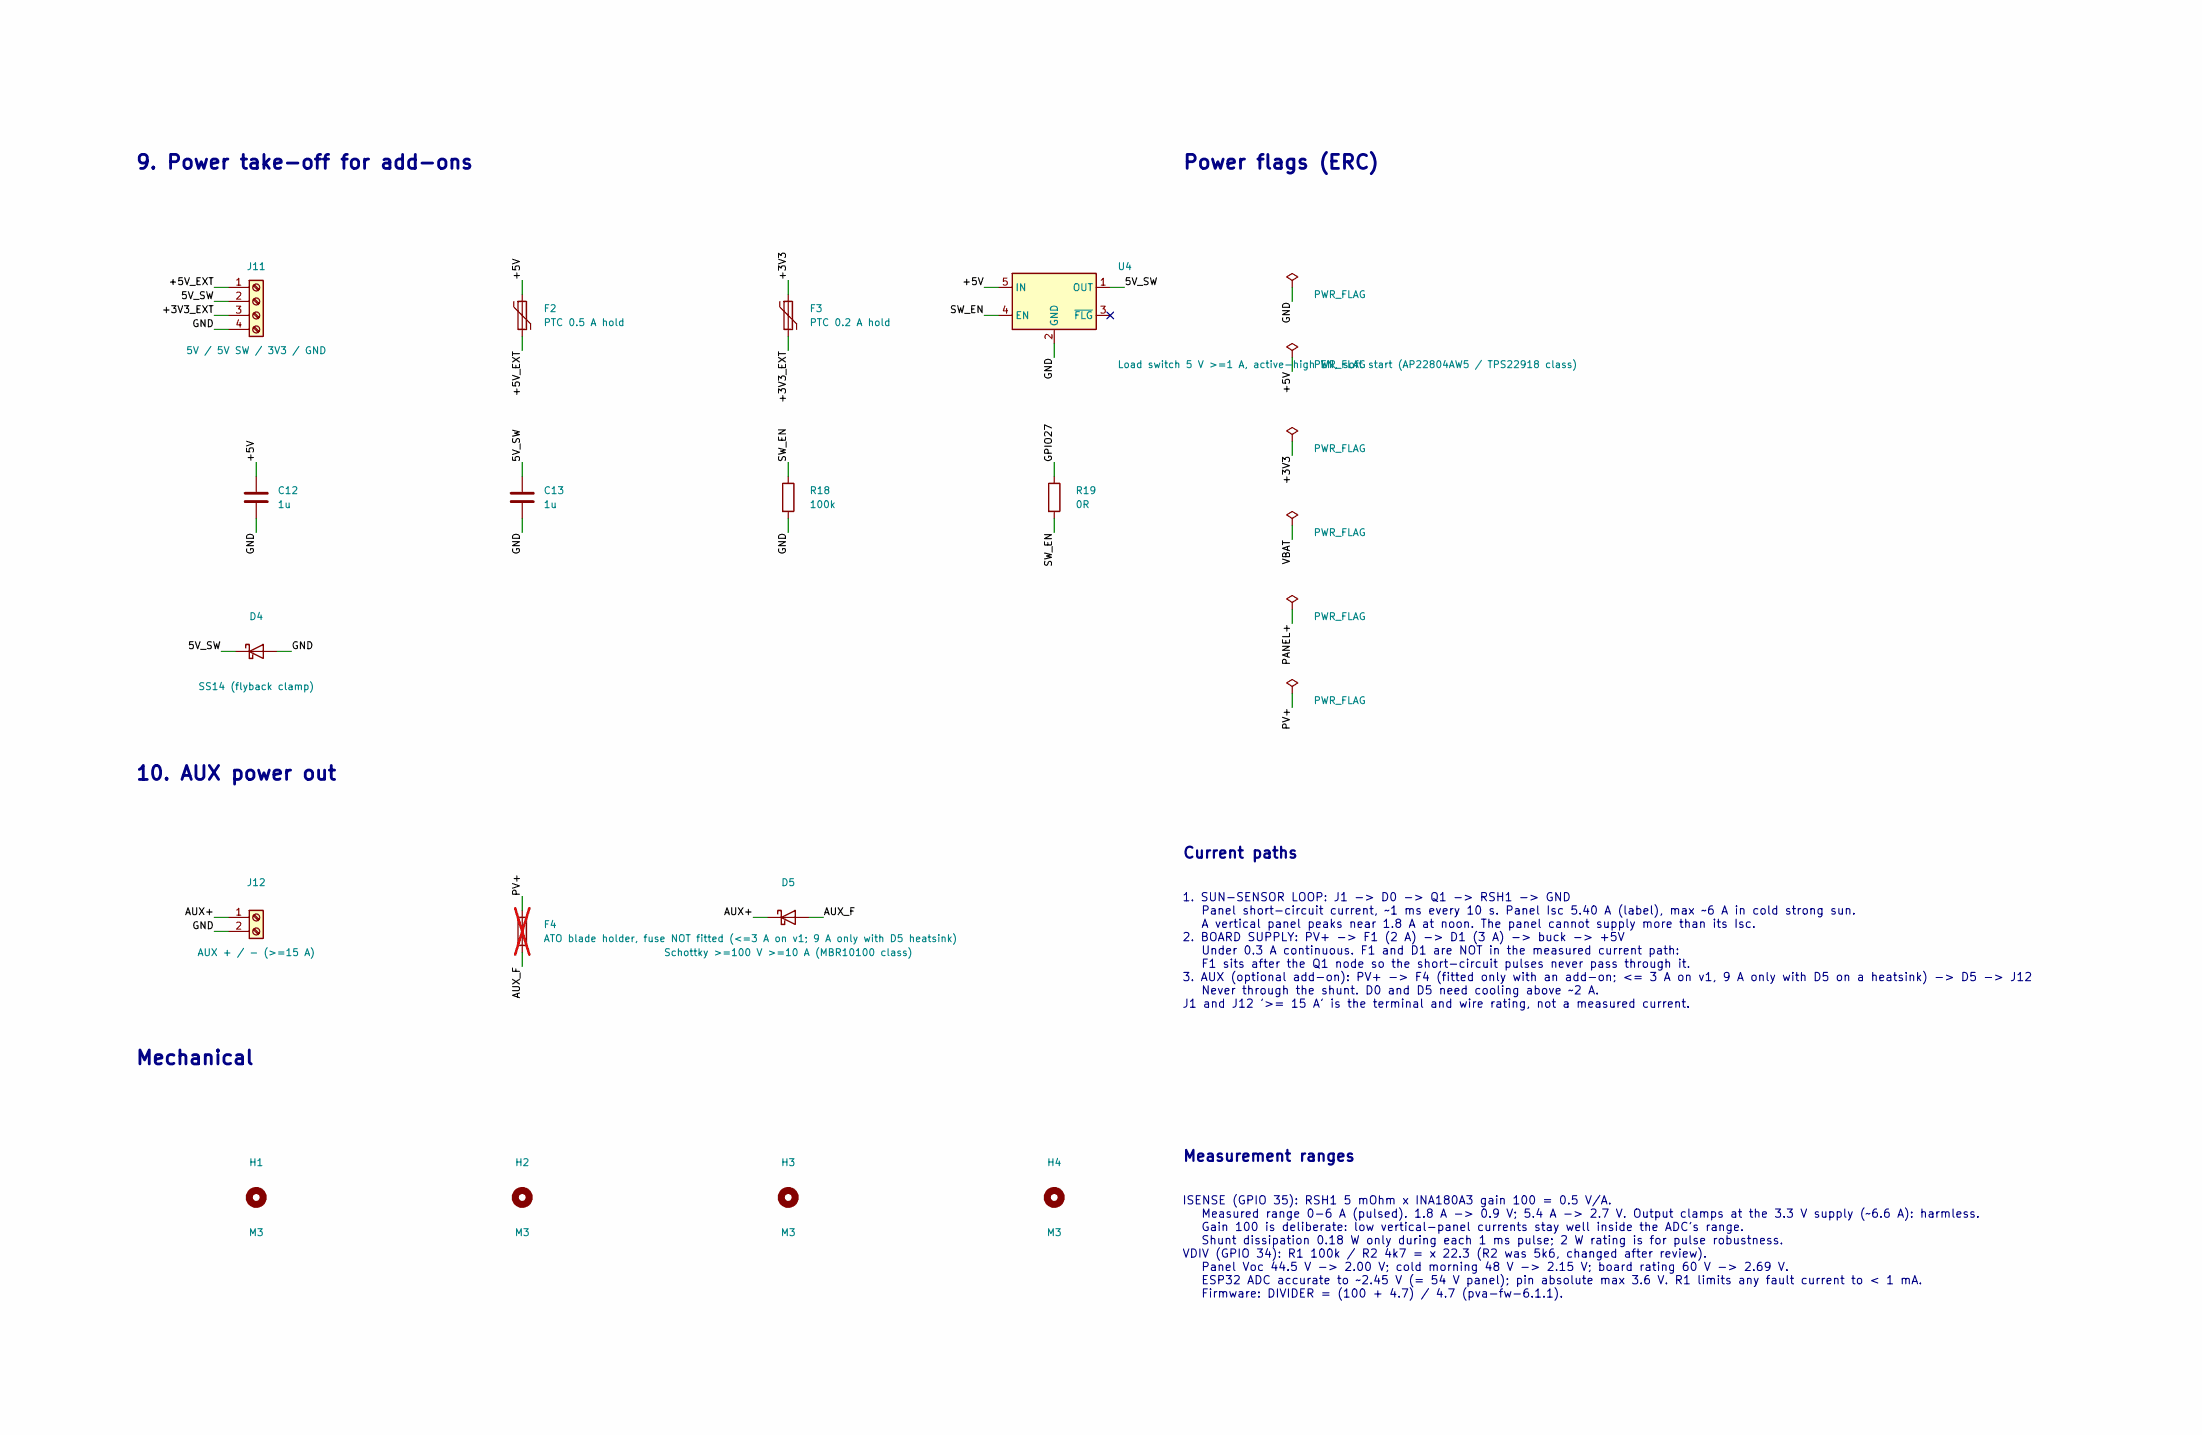
[picture p10: schematic carrier.kicad_sch, part in row 1, column 2]

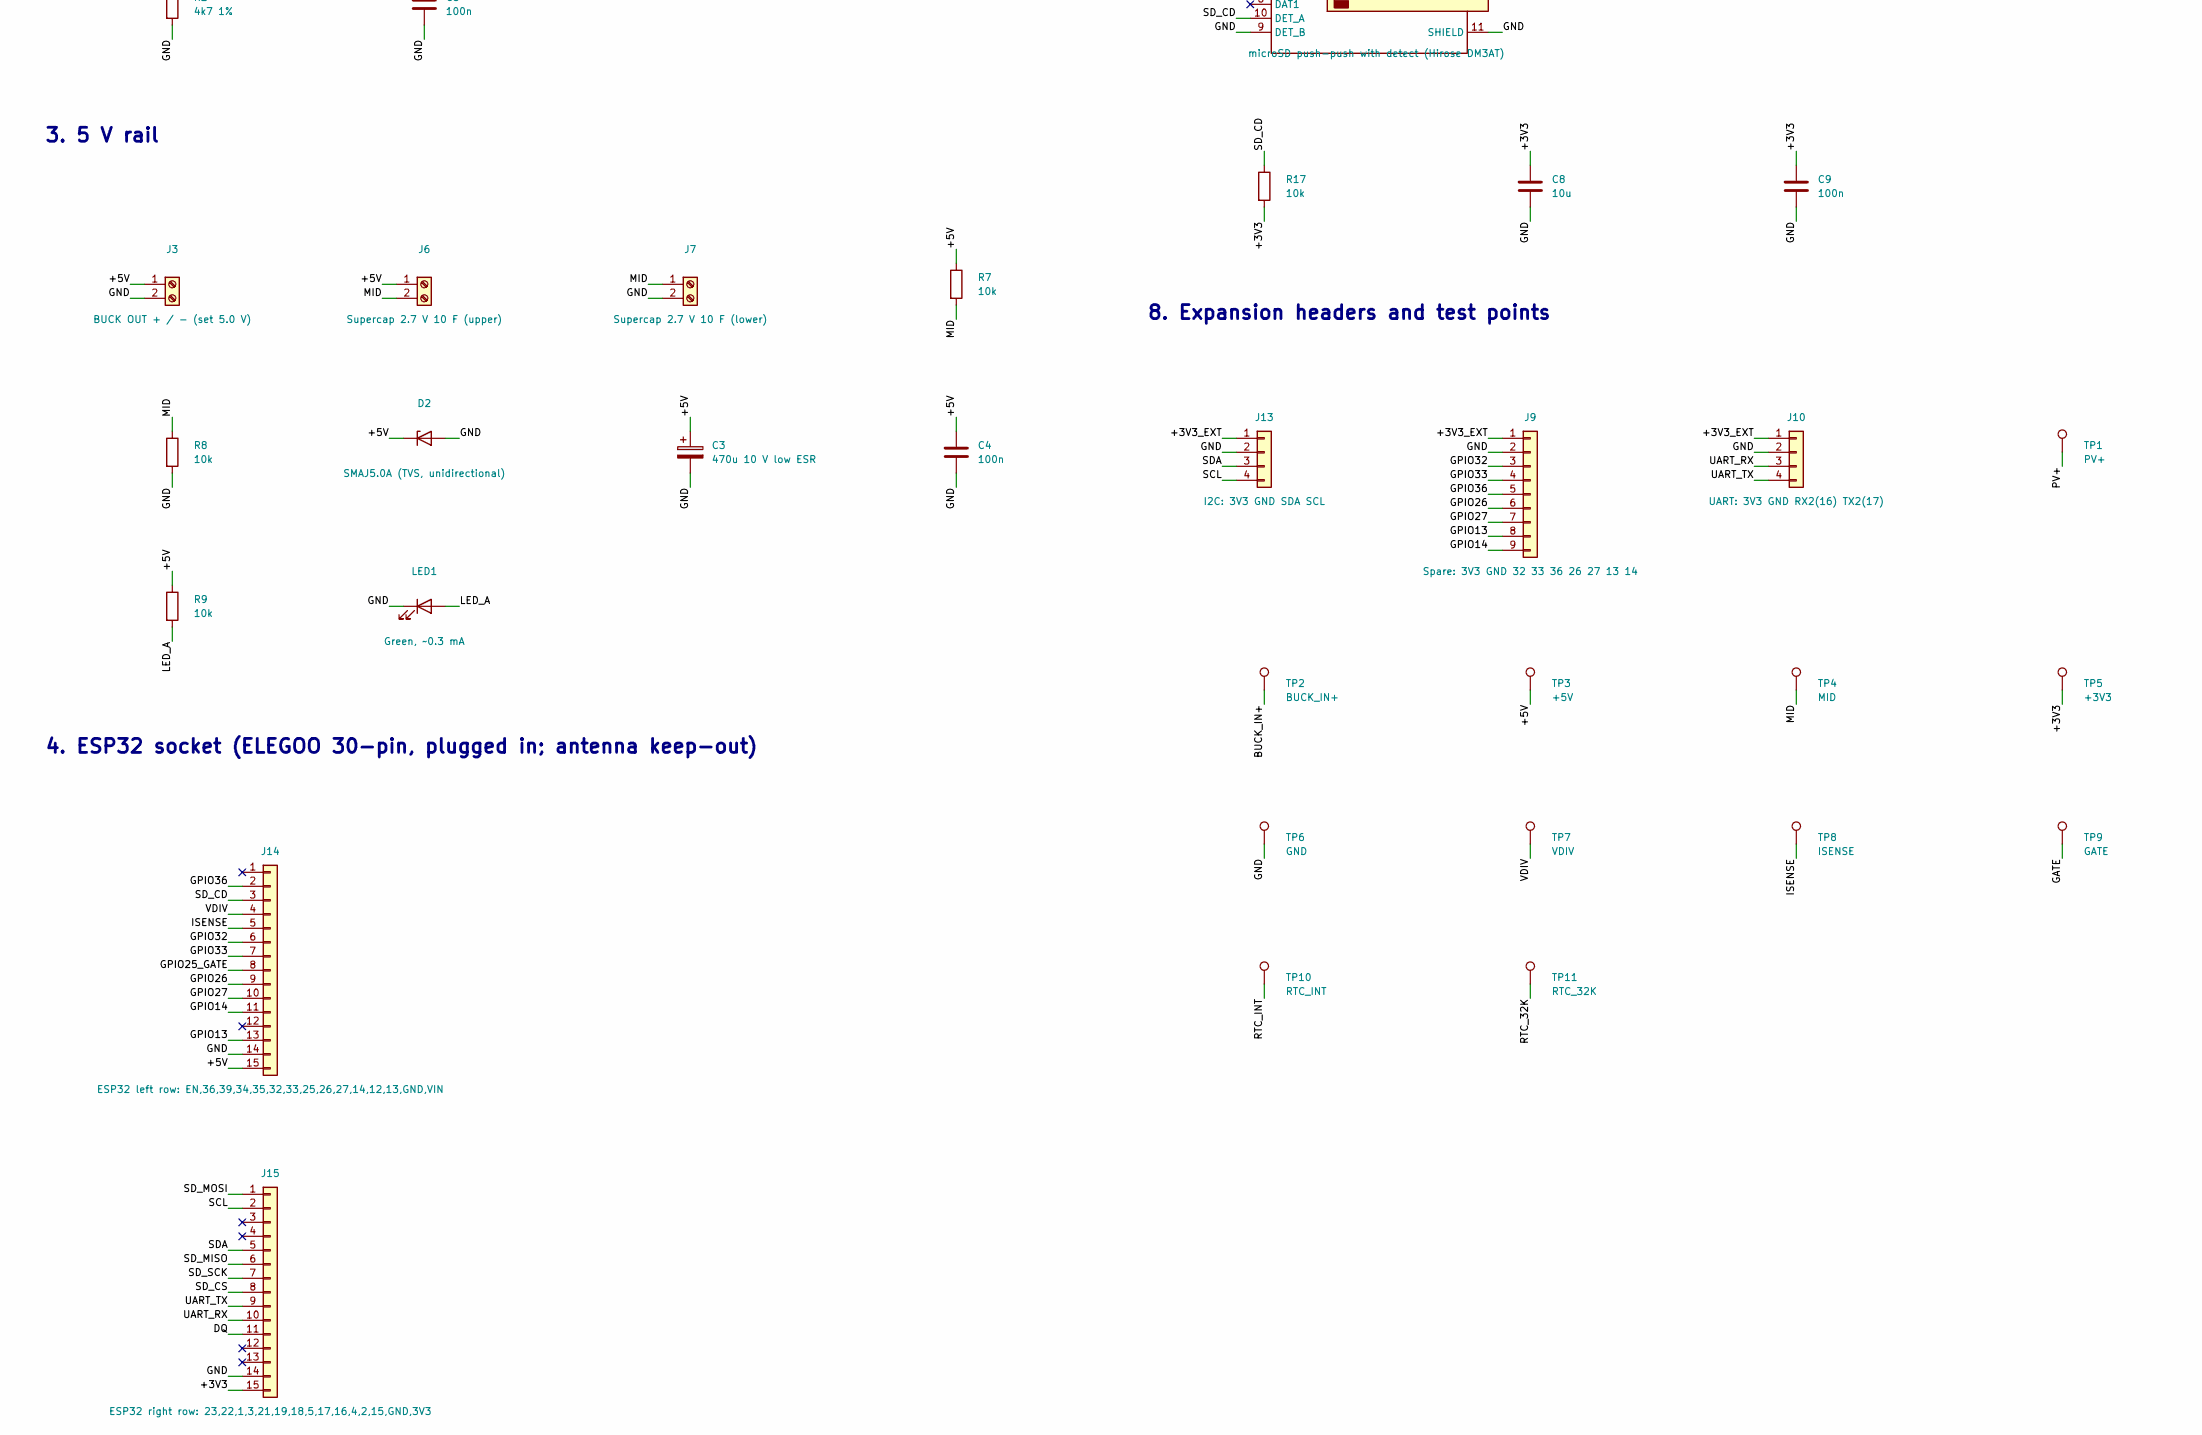
[picture p11: schematic carrier.kicad_sch, part in row 2, column 1]

Parts:
BT1: CR2032 holder (no charging); BatteryHolder_Keystone_3034_1x20mm
C3: 470u 10 V low ESR; CP_Elec_8x10.5
C4, C5, C6, C9, C10: 100n; C_0603_1608Metric
C7: 10n; C_0603_1608Metric
C8: 10u; C_0805_2012Metric
C11, C12, C13: 1u; C_0603_1608Metric
D0: >=100 V >=15 A dual Schottky (e.g. 20 A 100 V); TO-263-2
D1: S3M (1000 V 3 A); D_SMC
D2: SMAJ5.0A (TVS, unidirectional); D_SMA
D3: ESD 3.3 V (e.g. PESD3V3L1BA); D_SOD-323
D4: SS14 (flyback clamp); D_SMA
D5: Schottky >=100 V >=10 A (MBR10100 class); TO-220-2_Vertical
D6: DNP: SMCJ58A TVS (fit after bench test if needed); D_SMC; not fitted
F1: 2 A slow-blow; Fuse_1812_4532Metric
F2: PTC 0.5 A hold; Fuse_1206_3216Metric
F3: PTC 0.2 A hold; Fuse_0805_2012Metric
F4: ATO blade holder, fuse NOT fitted (<=3 A on v1; 9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; FuseHolder_Blade_ATO_Littelfuse_FLR_178.6165; not fitted
H1, H2, H3, H4: M3; MountingHole_3.2mm_M3
J1: PANEL+ / PANEL- (>=15 A, 4-6 mm2); TerminalBlock_MetzConnect_Type067_RT01902HDWC_1x02_P10.00mm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
J2: BUCK IN + / -; TerminalBlock_Phoenix_MKDS-1,5-2-5.08_1x02_P5.08mm_Horizont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
J3: BUCK OUT + / - (set 5.0 V); TerminalBlock_Phoenix_MKDS-1,5-2-5.08_1x02_P5.08mm_Horizont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
J4: DS18B20: 3V3 / DATA / GND; TerminalBlock_Phoenix_PT-1,5-3-3.5-H_1x03_P3.50mm_Horizontal
J5: Optional 2nd probe; TerminalBlock_Phoenix_PT-1,5-3-3.5-H_1x03_P3.50mm_Horizontal
J6: Supercap 2.7 V 10 F (upper); TerminalBlock_Phoenix_MKDS-1,5-2-5.08_1x02_P5.08mm_Horizont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
J7: Supercap 2.7 V 10 F (lower); TerminalBlock_Phoenix_MKDS-1,5-2-5.08_1x02_P5.08mm_Horizont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
J8: microSD push-push with detect (Hirose DM3AT); microSD_HC_Hirose_DM3AT-SF-PEJM5
J9: Spare: 3V3 GND 32 33 36 26 27 13 14; PinHeader_1x09_P2.54mm_Vertical
J10: UART: 3V3 GND RX2(16) TX2(17); PinHeader_1x04_P2.54mm_Vertical
J11: 5V / 5V SW / 3V3 / GND; TerminalBlock_Phoenix_PT-1,5-4-3.5-H_1x04_P3.50mm_Horizontal
J12: AUX + / - (>=15 A); TerminalBlock_MetzConnect_Type067_RT01902HDWC_1x02_P10.00mm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
J13: I2C: 3V3 GND SDA SCL; PinHeader_1x04_P2.54mm_Vertical
J14: ESP32 left row: EN,36,39,34,35,32,33,25,26,27,14,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; PinSocket_1x15_P2.54mm_Vertical
J15: ESP32 right row: 23,22,1,3,21,19,18,5,17,16,4,2,1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; PinSocket_1x15_P2.54mm_Vertical
JP1: Jumper: remove = sun sensor off; PinHeader_1x02_P2.54mm_Vertical
LED1: Green, ~0.3 mA; LED_0603_1608Metric
Q1: N-MOSFET >=60 V (>=100 V if D6 fitted) >=20 A Rds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; TO-252-2
R1: 100k 1%; R_0805_2012Metric
R2: 4k7 1%; R_0603_1608Metric
R4: 10R; R_0603_1608Metric
R5, R9, R14, R15, R16, R17: 10k; R_0603_1608Metric
R6: 1k; R_0603_1608Metric
R7, R8: 10k; R_0805_2012Metric
R10, R11, R12: 4k7; R_0603_1608Metric
R13: 100R; R_0603_1608Metric
R18, R21: 100k; R_0603_1608Metric
R19: 0R; R_0603_1608Metric
R20: DNP; R_0603_1608Metric; not fitted
RSH1: 5m 1% 2512 >=2 W; R_2512_6332Metric
RSH2: DNP (option: 2x 10m); R_2512_6332Metric; not fitted
TP1: PV+; TestPoint_Loop_D2.50mm_Drill1.0mm
TP2: BUCK_IN+; TestPoint_Loop_D2.50mm_Drill1.0mm
TP3: +5V; TestPoint_Loop_D2.50mm_Drill1.0mm
TP4: MID; TestPoint_Loop_D2.50mm_Drill1.0mm
TP5: +3V3; TestPoint_Loop_D2.50mm_Drill1.0mm
TP6: GND; TestPoint_Loop_D2.50mm_Drill1.0mm
TP7: VDIV; TestPoint_Loop_D2.50mm_Drill1.0mm
TP8: ISENSE; TestPoint_Loop_D2.50mm_Drill1.0mm
TP9: GATE; TestPoint_Loop_D2.50mm_Drill1.0mm
TP10: RTC_INT; TestPoint_Loop_D2.50mm_Drill1.0mm
TP11: RTC_32K; TestPoint_Loop_D2.50mm_Drill1.0mm
U1: DS3231SN (or RV-3028-C7, firmware change); SOIC-16W_7.5x10.3mm_P1.27mm
U2: INA180A3 (gain 100); SOT-23-5
U3: MCP1416 (or TC4427A class); SOT-23-5
U4: Load switch 5 V >=1 A, active-high EN, soft start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; SOT-23-5

Connections:
5V_SW: C13.1, D4.1 (K), J11.2, U4.1 (OUT)
+3V3: C6.1, C8.1, C9.1, C10.1, F3.1, J4.1, J5.1, J8.4 (VDD), J15.15, R10.2, R11.2, R12.2, R14.2, R15.2, R16.2, R17.2, R20.2, TP5.1, U1.2 (VCC), U2.5 (V+)
+3V3_EXT: F3.2, J9.1, J10.1, J11.3, J13.1
+5V: C3.1, C4.1, C11.1, C12.1, D2.1 (K), F2.1, J3.1, J6.1, J14.15, R7.1, R9.1, TP3.1, U3.2 (Vdd), U4.5 (IN)
+5V_EXT: F2.2, J11.1
AUX+: D5.1 (K), J12.1
AUX_F: D5.2 (A), F4.2
BUCK_IN+: D1.1 (K), J2.1, TP2.1
DQ: J15.11, R13.2
DQ_T: D3.1 (A1), J4.2, J5.2, R12.1, R13.1, R20.1
GATE: Q1.1 (G), R4.2, R21.1, TP9.1
GATE_DRV: R4.1, U3.5 (OUT)
GATE_IN: JP1.2 (B), R5.1, U3.3 (IN)
GND: BT1.2 (-), C3.2, C4.2, C5.2, C6.2, C7.2, C8.2, C9.2, C10.2, C11.2, C12.2, C13.2, D2.2 (A), D3.2 (A2), D4.2 (A), D6.2 (A), J1.2, J2.2, J3.2, J4.3, J5.3, J7.2, J8.6 (VSS), J8.9 (DET_B), J8.11 (SHIELD), J9.2, J10.2, J11.4, J12.2, J13.2, J14.14, J15.14, LED1.1 (K), R2.2, R5.2, R8.2, R18.2, RSH1.2, RSH2.2, TP6.1, U1.5 (GND), U1.6 (GND), U1.7 (GND), U1.8 (GND), U1.9 (GND), U1.10 (GND), U1.11 (GND), U1.12 (GND), U1.13 (GND), U2.2 (GND), U2.4 (-), U3.4 (GND), U4.2 (GND)
GPIO13: J9.8, J14.13
GPIO14: J9.9, J14.11
GPIO25_GATE: J14.8, JP1.1 (A)
GPIO26: J9.6, J14.9
GPIO27: J9.7, J14.10, R19.1
GPIO32: J9.3, J14.6
GPIO33: J9.4, J14.7
GPIO36: J9.5, J14.2
ISENSE: C7.1, J14.5, R6.2, TP8.1
ISENSE_RAW: R6.1, U2.1
LED_A: LED1.2 (A), R9.2
MID: J6.2, J7.1, R7.2, R8.1, TP4.1
PANEL+: D0.1 (K), D0.3 (K), J1.1
PV+: D0.2 (A), D6.1 (K), F1.1, F4.1, Q1.2 (D), TP1.1
PV_F: D1.2 (A), F1.2, R1.1
RTC_32K: TP11.1, U1.1 (32KHZ)
RTC_INT: TP10.1, U1.3 (~INT/SQW)
SCL: J13.4, J15.2, R11.1, U1.16 (SCL)
SDA: J13.3, J15.5, R10.1, U1.15 (SDA)
SD_CD: J8.10 (DET_A), J14.3, R17.1
SD_CS: J8.2 (DAT3/CD), J15.8, R14.1
SD_MISO: J8.7 (DAT0), J15.6, R16.1
SD_MOSI: J8.3 (CMD), J15.1, R15.1
SD_SCK: J8.5 (CLK), J15.7
SHUNT_TOP: Q1.3 (S), R21.2, RSH1.1, RSH2.1, U2.3 (+)
SW_EN: R18.1, R19.2, U4.4 (EN)
UART_RX: J10.3, J15.10
UART_TX: J10.4, J15.9
VBAT: BT1.1 (+), U1.14 (VBAT)
VDIV: C5.1, J14.4, R1.2, R2.1, TP7.1

Notes on the sheet:
PVA carrier board v1 - schematic draft generated from hardware/CARRIER.md. Label style: nets join by name. Engineer review required before manufacture.
1. Panel input and sun sensor
2. Fuse, diode, divider
3. 5 V rail
4. ESP32 socket (ELEGOO 30-pin, plugged in; antenna keep-out)
5. Clock
6. Temperature probes
7. microSD (future-proofing)
8. Expansion headers and test points
9. Power take-off for add-ons
10. AUX power out
Mechanical
Power flags (ERC)
Current paths
1. SUN-SENSOR LOOP: J1 -> D0 -> Q1 -> RSH1 -> GND Panel short-circuit current, ~1 ms every 10 s. Panel Isc 5.40 A (label), max ~6 A in cold strong sun. A vertical panel peaks near 1.8 A at noon. The panel cannot supply more than its Isc. 2. BOARD SUPPLY: PV+ -> F1 (2 A) -> D1 (3 A) -> buck -> +5V U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
Measurement ranges
ISENSE (GPIO 35): RSH1 5 mOhm x INA180A3 gain 100 = 0.5 V/A. Measured range 0-6 A (pulsed). 1.8 A -> 0.9 V; 5.4 A -> 2.7 V. Output clamps at the 3.3 V supply (~6.6 A): harmless. Gain 100 is deliberate: low vertical-panel currents stay well inside the ADC's range. Shunt dissipation 0.18 W only durin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
ESP32 module and Q1 gate (review 2)
The ESP32 is a complete ELEGOO dev board plugged into J14/J15. Its EN pull-up, reset and boot buttons, USB-serial converter and strapping resistors are on that board, not on the carrier. EN and GPIO 0, 1, 2, 3, 12, 15 are deliberately not brought out. GPIO 5 (strapping) is held high by R14. Q1 gate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
