blankworker1/PVA/hardware/carrier/mpn.py

# Proposed manufacturer part numbers for the BOM (added 23 Oct 2026, for manufacturer quotes).
# ref -> (manufacturer, MPN, check). check = "" when confident; otherwise what the manufacturer should confirm.
# Equivalent parts are welcome: the Value / rating column is the requirement, the MPN one way to meet it.

def yageo(code, size="0603", tol="F"):
    return ("Yageo", f"RC{size}{tol}R-07{code}L", "")

MPN = {
    "BT1": ("Keystone Electronics", "3034", ""),
    "C3": ("Panasonic", "EEE-FK1A471P", "470 uF 10 V FK series, 8 x 10.2 mm; check fit on the 8 x 10.5 footprint"),
    **{r: ("Murata", "GRM188R71H104KA93D", "") for r in ["C4", "C5", "C6", "C9", "C10"]},
    "C7": ("Murata", "GRM188R71H103KA01D", ""),
    "C8": ("Murata", "GRM21BR61C106KE15L", ""),
    **{r: ("Murata", "GRM188R71E105KA12D", "") for r in ["C11", "C12", "C13"]},
    "D0": ("onsemi", "MBRB20100CTT4G", "D2PAK, 100 V 20 A dual common cathode, anodes (pins 1, 3) in parallel"),
    "D1": ("Vishay", "S3M-E3/57T", ""),
    "D2": ("Littelfuse", "SMAJ5.0A", ""),
    "D3": ("Nexperia", "PESD3V3L1BA,115", ""),
    "D4": ("Vishay", "SS14-E3/61T", ""),
    "D5": ("onsemi", "MBR10100G", ""),
    "D6": ("Littelfuse", "SMCJ58A", "DNP"),
    "F1": ("(manufacturer to propose)", "", "1812 time-delay (slow-blow) fuse, 2 A, >= 63 V DC. If no 1812 part suits, Bourns SF-1206S200-2 (1206, 2 A time-lag) with the footprint changed to 1206"),
    "F2": ("Bourns", "MF-NSMF050-2", ""),
    "F3": ("Bourns", "MF-PSMF020X-2", "0805, 0.2 A hold; confirm size"),
    "F4": ("Littelfuse", "178.6165.0002", "Holder only, fuse not fitted"),
    **{r: ("Metz Connect", "RT01902HDWC", "") for r in ["J1", "J12"]},
    **{r: ("Phoenix Contact", "1715721", "MKDS 1,5/ 2-5,08") for r in ["J2", "J3", "J6", "J7"]},
    **{r: ("Phoenix Contact", "1984633", "PT 1,5/ 3-3,5-H") for r in ["J4", "J5"]},
    "J8": ("Hirose", "DM3AT-SF-PEJM5", ""),
    "J9": ("Würth Elektronik", "61300911121", ""),
    **{r: ("Würth Elektronik", "61300411121", "") for r in ["J10", "J13"]},
    "J11": ("Phoenix Contact", "1984646", "PT 1,5/ 4-3,5-H"),
    **{r: ("Würth Elektronik", "61301511821", "Female socket, 15 way; confirm it is the socket, not the pin header") for r in ["J14", "J15"]},
    "JP1": ("Würth Elektronik", "61300211121", "Plus a 2.54 mm jumper (fitted by the builder)"),
    "LED1": ("Würth Elektronik", "150060GS75000", ""),
    "Q1": ("Infineon", "IRLR3110ZTRPBF", "100 V logic-level D-Pak; confirm Rds(on) <= 20 mOhm at Vgs 4.5 V from the datasheet"),
    "R1": yageo("100K", "0805"),
    "R2": yageo("4K7"),
    "R4": yageo("10R"),
    **{r: yageo("10K") for r in ["R5", "R9", "R14", "R15", "R16", "R17"]},
    "R6": yageo("1K"),
    **{r: yageo("10K", "0805") for r in ["R7", "R8"]},
    **{r: yageo("4K7") for r in ["R10", "R11", "R12"]},
    "R13": yageo("100R"),
    **{r: yageo("100K") for r in ["R18", "R21"]},
    "R19": ("Yageo", "RC0603JR-070RL", ""),
    "R20": ("Yageo", "RC0603FR-071KL", "DNP; value to set on the bench if a long probe cable needs it"),
    "RSH1": ("Bourns", "CRA2512-FZ-R005ELF", "5 mOhm 1 % 3 W"),
    "RSH2": ("Bourns", "CRA2512-FZ-R010ELF", "DNP; option: two in parallel instead of RSH1"),
    **{f"TP{i}": ("Keystone Electronics", "5000", "") for i in range(1, 12)},
    "U1": ("Analog Devices / Maxim", "DS3231SN#", ""),
    "U2": ("Texas Instruments", "INA180A3IDBVR", ""),
    "U3": ("Microchip", "MCP1416T-E/OT", ""),
    "U4": ("Diodes Inc.", "AP22804AW5-7", ""),
}
