blankworker1/PVA/firmware/panel_page_server/panel_config.example.h

// PVA — per-panel settings
// Copy this file to panel_config.h in the same folder and edit it for each panel
// before flashing. panel_config.h is listed in .gitignore: real keys never go in the repo.

#pragma once

#define PVA_PANEL_ID   "panel-01"      // Wi-Fi name; panel-01 … panel-09
#define PVA_AP_PASS    ""              // "" = open network
#define PVA_ADMIN_KEY  "change-me"     // a long, different key for every panel
