blankworker1/PVA/(commit log)

2026-10-17 Arrange files into the documented layout
    Move the firmware, its data folder and per-panel config template into
    firmware/panel_page_server/ so it is a complete Arduino sketch folder, move
    the sample tools into tools/, and rename gitignore to .gitignore.
    Claude-Session: https://claude.ai/code/session_018mF6KHAMCQiGeY8hbCaRVk
    [partitions.csv]
2026-10-17 Support the ELEGOO ESP32 30-pin board and staged builds
    Add a 4 MB partition table as the default (the 16 MB S3 layout is kept as
    partitions_16mb.csv), preset pins for the original ESP32 (DS18B20 on GPIO 4,
    panel divider on GPIO 34, DS3231 on 21/22), and add BENCH, PANEL_SENSE and
    USE_RTC switches so the same firmware runs from the bench test through to a
    full panel. Without the divider, the dawn gate and dusk close are skipped and
    the supercapacitor smooths the start. README updated with the stage table and
    the stage 1 and 2 hardware lists.
    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
    [partitions.csv, partitions_16mb.csv]
2026-10-17 Add the sundial and mounting spec
    hardware/SUNDIAL.md covers the gnomon (50 degrees, 60 cm), the hour lines in
    solar time, the drilling template for the 80 x 160 cm portrait panel, packing
    one edge out so every panel faces due south, the noon-shadow wall test with a
    solar-noon table for Bosa, what vertical mounting means for the data, and what
    to recalculate before reusing the panels. Linked from the README.
    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
2026-10-18 Firmware draft 6 and rules v1 on the panel page
    - Sun sensor (SUN_SENSE): short-circuit current every 10 s, logged every minute;
    15-minute solar-section verdicts sealed at sunset; admin calibration.
    - Presence: distinct phones per solar hour, salted hash in RAM only.
    - Panel page draws rules v1 (sun ring, heat, axis, presence dots, failed days).
    - Admin: calibrate button, sun current and reference in status.
    - pva_rules.py: unknown sections drawn as outline, as on the panel page.
    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
    [panel_page_server.ino]
2026-10-18 Add the girasole: map pin, admin round, visitor experience
    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
2026-10-18 Add the print shop enquiry
    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
2026-10-18 Print enquiry and A4 sample: header SUNDIAL · La Meridiana
    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
2026-10-18 Sample sheet now builds into texts/
    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
2026-10-18 Sample sheet: 'not in sun' key, a failed-day tile, Italian version
    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
2026-10-18 Print shop pack: Italian and English enquiry
    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
2026-10-18 A4 mock-up of the full print, 63 tiles, English and Italian
    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
2026-10-18 Wall version at real measurements: 210 mm cells, 30 mm corner cuts, 2/4 mm gaps
    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
2026-10-18 Firmware 6.1: BENCH_FAKE desk test with no sensors; probe pin optional on S3
    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
2026-10-18 Carrier board specification v1; sun MOSFET goes before the fuse
    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
2026-10-18 Carrier: microSD socket and spare-pins header for future expansion
    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
2026-10-18 Carrier: bring out every safe spare ESP32 pin
    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
2026-10-18 Carrier: fused 5 V, switched 5 V and 3.3 V power take-off
    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
2026-10-18 Carrier: flyback clamp so 5V SW can drive a relay coil
    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
2026-10-18 Carrier: AUX power out for spare panel capacity, with its own fuse and diode
    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
2026-10-18 Carrier review: input diode protects the sun MOSFET, 2 A fuse, refs, bench test
    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
2026-10-18 Wiring notes: input Schottky ahead of the sun MOSFET
    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
2026-10-18 Carrier: ESP32 row spacing 25.4 mm (provisional, from the listing)
    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
2026-10-18 Carrier: firm antenna keep-out rule and box orientation
    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
2026-10-19 Panel label: INA180A3 gain 100 for a vertical panel, 9 A AUX fuse limit, frame data
    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
2026-10-19 Carrier: brief for the board designer (deliverables, choices, provisional items)
    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
2026-10-20 Carrier v1 schematic draft (KiCad) generated from CARRIER.md: schematic, PDF, netlist, BOM, checks
    Draft-1, not reviewed. 205 pin connections verified against KiCad's own netlist export.
    Claude-Session: https://claude.ai/code/session_01BMFMt5yCJVT3JQicJnUWqs
    [carrier.kicad_sch]
2026-10-20 Carrier review 1: R2 4.7k (divider in ADC range), current-path and range notes on the schematic; firmware DIVIDER (6.1.1); BOM now tracked
    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
    [bom.csv, carrier.kicad_sch]
2026-10-20 Carrier review 2 (Copilot): R21 Q1 gate pull-down, D6 TVS footprint, AUX 3 A on v1, AP22804 verified, ESP32 module note
    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
    [bom.csv, carrier.kicad_sch]
2026-10-20 Carrier README: linked Start-here section for the designer; spec PDF regenerated from current CARRIER.md
    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
2026-10-20 CARRIER.md: brief updated now the schematic exists (review, parts, layout, build); schematic hand-over rule; spec PDF regenerated
    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
2026-10-20 CARRIER.md: 'What the board does' section for the designer; spec PDF regenerated
    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
2026-10-20 Fix duplicate description in CARRIER.md
    Removed duplicate text about the board's power source and installation.
2026-10-22 Add interactive-auction.md: carrier v1 on the battery tier and the street auction
    USES.md gains section 8 (the battery tier) pointing to the new spec;
    README lists the new file.
    Claude-Session: https://claude.ai/code/session_01PYggKV6J6nFvCyx7PSvpos
2026-10-22 Rename GO TO BED to SUNSET; the auction's hammer falls at sunset
    The day's business closes at Bosa's sunset (from the clock, as SUNDIAL's
    seal), not at bedtime. Adds the same-evening collection question.
    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
2026-10-22 Auction: three lockers (wings in, stage, wings out), daylight-only business, four evening hours of light
    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
2026-10-22 Audio node: Bluetooth amplifier first, wired DAC fallback; amp inside the enclosure, speakers plugged in for the set
    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
2026-10-22 Audio node: panel as Bluetooth transmitter to a registered speaker; optional speaker locker that charges it
    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
2026-10-22 Add interactive-arm-game.md: the robot-arm dexterity node (pegs in holes)
    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
2026-10-22 Add interactive-print.md: proof of print, a mint node turning digital stamps into paper stamps and back
    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
2026-10-22 Print node: each mint issues two parts, the artwork stamp (gift) and the redeem sticker (value)
    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
2026-10-22 Print node: souvenir mode (artwork stamp sold alone for digital stamps) beside convert mode
    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
2026-10-22 SUNSET: the print node and flip-dot wall as the gateway; hosts; status-by-serial check
    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
2026-10-22 Rename hardware/SUNDIAL.md to hardware/GNOMON.md
    Two files called SUNDIAL.md were confusing after the rename of USES.md;
    the hardware one is the gnomon, drilling template and mounting. Links in
    README, SUNDIAL.md and FORK-TASKS updated.
    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
2026-10-23 Carrier: proposed manufacturer part numbers for every BOM line; Altium/Allegro note
    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
    [bom.csv]
2026-10-23 hardware/POST.md: the free-standing panel, with USB charging from the sun
    For sites with no suitable wall, on private ground such as a café's
    seating area. Same panel, gnomon and carrier v1; no battery and no board
    change: a wide-input USB-C PD charger on AUX (J12), switched by J11 5V SW,
    cut whenever the panel sags. Heights for gnomon safety, indicative wind
    load and base options, siting, permissions, bench tests. Linked from
    GNOMON.md, SUNDIAL.md 1 and the README.
    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
